salvailuciano/PPS/README.md

# PPS LIECOM

## Cómo poner la placa ESP32 en modo "Programacion"
1. Conectar cable USB
2. Apretar el botón "BOOT" de la placa
3. Soltar boton cuando aparezca programando en arduino
