salvailuciano/PPS/5_Informacion del Ale/Proyecto Reemplazo V7S-00-ÍNDICE.odt

PROYECTO REEMPLAZO V7S-00-ÍNDICE

R2021-09-27. (2 pág.)

Borrador comentarios preliminares para analizar en fábrica sobre voltímetro control.

01- CONTROL. (2 pág.)

Borrador idea genérica de análisis en fábrica de anexar posibles funciones de control.

P0794A_HD.pdf (1 pág.)

Borrador idea hardware mediciones y control.

02- GENERALIDADES. (2 pág.)

Funciones como voltímetro. Cantidad canales y multiplexación. Promediación. Resolución mediciones. Resolución display. Loop mediciones. Escalas en Eeprom.

03- PROMEDIACIÓN. (1 pág.)

Algoritmos para promediar cada canal.

04- ESCALAS. (1 pág.)

Conversión de salidas de los adc a valores a mostrar en display. Datos no volátiles (Eeprom).

05- FORMATOS PRESENTACIÓN DISPLAY. (2 pág.)

Presentación para mediciones lineales, cuadráticas y cuadráticas con máxima resolución.

06- EEPROM ESCALAS. (2 pág.)

Parámetros guardados en eeprom para calibración entradas analógicas. Display en modo vúmetro.

07- EEPROM REFERENCIA. (3 pág.)

Muestra organización eeprom equipos anteriores para tener como referncia.

08- PROTOCOLO COMUNICACIÓN. (6 pág.)

Muestra protocolo comunicación con PC en otros equipos. Tenerlo presente para tratar de hacer similar o compatible.

09- DIAGRAMA CONTROL GENERAL. (1 pág.)

Descripción resumida de posibles funciones de control a desarrollar.

P0794-A_DF-VOLT Y CTRL CON MICRO Rev1.pdf (1 pág.)

Diagrama funcionamiento Control General.

10- DETALLES CONTROL GENERAL. (6 pág)

Explicación Diagrama Control General.

continúa.....

Salida dac Ajuste de Potencia.

Salida pwm ventiladores.

Funciones Teclado y Leds.

Logbook eventos.

Proyecto Reemplazo V7S-00-ÍNDICE.odt 09/11/2021 de 1
