salvailuciano/PPS/5_Informacion del Ale/Proyecto Reemplazo V7S-01-CONTROL.odt

La placa de mediciones digitales deberá encargarse también del Control General del equipo. Esto es fijar modo de encendido, realizar las distintas protecciones, ajustar la potencia del equipo, etc.

Para el diseño funcional de los bloques de Control General (del Tx), se tomará referencia el funcionamiento de las placas P0167, P0490 y P0534, y para implementarlo con el (mismo) microcontrolador, este recibirá las siguientes informaciones, y generará las salidas que correspondan:

Lecturas entradas Lógicas

-Ingreso señal eléctrica LÓGICA ENC AUT en entrada LÓGICA.

-Ingreso señal eléctrica LÓGICA falla >>ROE en entrada LÓGICA.

-Ingreso señal eléctrica LÓGICA falla >>TEMP en entrada LÓGICA.

-Ingreso señal eléctrica LÓGICA P50 EXT en entrada LÓGICA (equipos FM1K / 2K).

-Ingreso señal eléctrica LÓGICA falla -VGG en entrada LÓGICA (P0167-B en TRM2640).

-Ingreso señal eléctrica LÓGICA apagado externo (posible uso futuro).

Lecturas entradas Analógicas

-Ingreso señal eléctrica ANALÓGICA NTC1 en entrada ADC.

-Ingreso señal eléctrica ANALÓGICA NTC2 en entrada ADC (estas entradas ADC no irían multiplexadas con las ADC de mediciones a mostrar en el display porque tienen interfaz entrada distinta).

-(analizar posible entrada para un tercer NTC3 en entrada ADC).

-Ingreso señal eléctrica ANALÓGICA Ref Temp NTC (definir si LM35 local o Med Temp Aire).

-Compartir ingreso señales eléctricas ANALÓGICAS de PD, PR y PEXC para el AGC y PMOD y VFTE para MUTE del AGC.

Lectura configuraciones en Eeprom seteadas desde PC por Lie

-Lectura de Eeprom VALOR (seteado desde PC) tipo de P0167/490: si <<VENT apaga FTE (P0490-A), ó saca Low en HVGG (pin 9 P0490-C), ó saca High en <<VENT (pin 9 P0490-D), ó <<VENT2 saca High en <<VSUM (pin 9 P0490-E); ó falla -VGG apaga (pin 1 P0167-B para TRM2640). Cada una de estas opciones además afecta la lógica si <<VENT apaga o no Tx.

-Lectura de Eeporm VALOR número ADC para referencia MED TEMP AIRE para <<VENT.

-Lectura de Eeprom VALORES ajuste comparadores VNTC para T_AIRE=0, para T_AIRE=40 y valor HISTÉRESIS (para simpleza se considerará como si la VNTC fuese lineal con la temperatura).

-Lectura de Eeprom si la actuación de >>T debe enclavar o no.

-Lectura de Eeprom qué entradas analógicas se usaría como med. de Temp. en caso de amplificadores sin termostáto (con P0673) para usar como >>TEMP e histéresis.

-Lectura de Eeprom VALOR PNOMinal del Tx.

-Lectura de Eeprom ubicaciones (entradas analógicas) mediciones PD, PR, PEXC y PMOD, y valores comparadores para AGC (PD_NOM, PE_NOM, PR_Foldback) y umbral PMOD, y rango (VMÍN, VMÁX), velocidad actuación AGC (pendiente V PIN respecto diferencia PD-PSET; también si deberán o no tener efecto c/u (PD, PR, PEXC y PMOD).

-Lectura de Eeprom VALORES Temp1 y Temp2 entre los cuales el PWM para turbinas (en caso de contemplarse en este diseño) dará un DC del 0% y del 100% respectivamente, y cuál entrada ADC se tomará como referencia (la del Aire, la del AMPL, etc).

-Lectura de Eeprom ubicaciones medición fuentes y valores de V a comparar para indicar Falla de Fuente (es una falla que no la venimos acusando pero suele ser bastante común en los equipos).

-Lectura de Eeprom retardo encendido automático al recibir señal del modulador, y retardo apagado al cesar.

Lecturas configuraciones en eeprom seteadas desde teclado por usuario Control en Tx

-Lectura de Eeprom estado LÓGICO (seteado desde teclado) Encendido Manual / Automático.

-Lectura de Eeprom estado LÓGICO (seteado desde teclado) Manual SI / NO.

-Lectura de Eeprom estados LÓGICOS (seteado desde teclado) cómo arranca al conectar 220 si se encontraba en MAN/SI o en AUT y con entrada de ENC AUT (APAG, ENC, ó como venía estando al cortarse 220).

-Lectura de Eeprom VALOR (seteado desde teclado) potencia deseada PSET (para AGC mediante microcontrolador).

Señales de Salida del uC para Control General del Tx

-Salida LÓGICA <<VENT/<<VENT2/LowHVGG/....Como ya se mencionó el pin 9 funciona de distintas maneras, y se indicó su lógica de acuerdo a la versión de la P0490 que corresponda (o la función homóloga en el pin 1 de la P0167). Quedará por definir si convendrá en el PCB hacer que sean pines distintos (y así podría evitarse ese seteo en la eeprom) pero consumiríamos más pines del microcontrolador.

-Salida LÓGICA Led Verde. Para indicar funcionamiento normal del Tx.

-Salida LÓGICA Led Rojo de APAG. Para indicar equipo apagado (por usuario).

-Salida LÓGICA Led Rojo. Para indicar fallas (ROE, TEMP, VENT, Fuente?, ....

-Salida LÓGICA Led Amarillo. Para indicar FoldBack ROE, o AGC controlado por EXC, o AGC al máx, ...(este led podría evitarse haciendo actuar simultaneamente el Verde y el Rojo de fallas ahorrando un pin del micro pero usando un led especial RO+VE).

-Salida LÓGICA energización relé HAB FTE.

-Salida LÓGICA HAB 12V.

-Salida LÓGICA HVGG.

-Salida LÓGICA energización NTC (por verificar si puede ser siempre la misma que habilita al relé HAB FTE).

-Salidas DAC para generar VAGC (hay uC con DACs de 5 bits; se utilizarían 2 DAC para 10 bits).

-Salida PWM VREF POT (opción en caso de no implementarse los DAC y AGC controlado).

-Salida PWM control ventiladores (opción a analizarse su implementación).

Otras conexiones del uC

-Entradas analógicas (cantidad dependerá de hardware de multiplexación).

-Display LCD (un LCD de 2 x 16 C utiliza unos 11 pines).

-Teclado (a definir, unos 5 pines).

-Comunicación con PC: dos pines Tx y Rx.

-Firmware: 3 pines.

Proyecto Reemplazo V7S-01-CONTROL.odt 30/09/2021 2 de 2
