salvailuciano/PPS/5_Informacion del Ale/Proyecto Reemplazo V7S-04-ESCALAS.odt

CONVERSIÓN SALIDA ADC AL VALOR A MOSTRAR EN DISPLAY

La calibración de la escala de cada canal a medir, se realizará por software según un conjunto de valores guardados en la eeprom.

Esto se hará mediante la PC conectada a la plaqueta (mas adelante se indicará si también será necesario poder hacer calibración desde el teclado).

El procedimiento sería como sigue:

Para cada canal en particular (16), una vez ingresado al menú de calibración, y habiendo leído desde la eeprom las características de LIN/CUAD, y de PROMEDIACIÓN del canal, se pondrá una tensión en la entrada correspondiente, para la que en la PC se mostrará en formato decimal un número correspondiaente a la salida promediada de ese adc (entre 0 y 1023, por ejemplo 789 y es para asegurar que la tensión de entrada esté en un valor razonable), y entonces en otro campo el usuario escribirá el valor que debiera mostrar el display una vez calibrado para esa entrada (digamos 1000), luego pulsando INTRO deberán quedar registrado en la eeprom para ese canal (2 bytes para CalADC y 2 bytes para CalDISPLAY), los valores CalADC (=789) y CalDISPLAY (=1000) respectivamente, finalizando así su calibración.

Luego para mostrar el valor adecuado en cada momento en el display, para ese canal, se deberá utilizar la fórmula que corresponda según sea lineal o cuadrática (atributo leído de la eeprom):

-para medición de escala cuadrática (como las mediciones de potencias) la fórmula a aplicar sería:

Px =[adc promediada / CalADC]^2 * CalDISPLAY

Px =[adc promediada / 789]^2 * 1000

si adc promediada fuese = 605, entonces Px sería = 588 W

-si la medición es de escala lineal (como mediciones de tensiones) la fórmula a aplicar sería:

Vx =[adc promediada / CalADC] * CalDISPLAY

Vx =[adc promediada / 789] * 1000

si adc promediada fuese = 801, entonces Vx sería = 1015 V

Al alimentar la plaqueta, el microcontrolador leerá de cada canal los valores en eeprom, y calculará para almacenar en ram CalDISPLAY / CalADC ^2 para las cuadráticas, y CalDISPLAY / CalADC para las lineales, con la resolución (cantidad de bits) suficiente.

USO DE LA EEPROM

La calibración ocuparía así, para cada canal (de 16) 4 bytes. Pero además al menos se dispondrían dos juegos de calibración (uno seteado antes de poner el equipo en marcha, y otro al momento de calibrar), sumando 8 bytes.

Además por canal consumirá 10 bytes para nombre y unidad de medición, un byte para modo LIN/CUAD y para PROMEDIACIÓN, y uno más para fondo escala vúmetro cuando corresponda. O sea unos 8 bytes más 12 bytes por canal.

Proyecto Reemplazo V7S-04-ESCALAS.odt 13/10/2021 de 1
