salvailuciano/PPS/5_Informacion del Ale/Proyecto Reemplazo V7S-05-RESOLUCIÓN DISPLAY.odt

FORMATOS PRESENTACIÓN DISPLAY

Al considerar el tipo de display a utilizar, se prevé que la presentación sea de las siguientes formas:

0,001 hasta 1,999; 0,01 hasta 19,99; 0,1 hasta 199,9; 1 hasta 1999.

El fondo de escala de 3 1/2 dígitos (apróx. 2000) debe permitir las cuatro posiciones posibles de ubicación del punto decimal indicados.

Y la resolución (ubicación del punto decimal) quedará determinado al momento de realizar la calibración para cada canal, y para mediciones lineales tendrá el punto en una única posición para cada canal sin importar el valor de salida de su adc, mientras que para mediciones cuadráticas habrá dos modos (fijados en eeprom desde la PC, para cada canal cuadrático en particular): uno con punto fijo como las lineales, y otro de máxima resolución. O sea resumiendo definiremos como Lineal, Cuadrática, y Cuadrática Máxima Resolución (este aplicable solo a las cuadráticas).

Aparte el hecho de no tener preset (mecánico o electrónico) antes de la entrada del adc, hará que la resolución del canal no sea aprovechada al máximo, porque para cierto fondo de escala en el display, la salida de ese adc puede estar cerca de 1023 (máximo aprovechamiento), o puede estar más cerca del 0; para el diseño supondremos que tenga capacidad para mostrar a fondo de escala cuando el adc esté en el orden de 128.

Veremos los cálculos y las posibles presentaciones en el display.

Mediciones Lineales con fondo de escala adc cercano a 1024:

ADC promediado Escala 2000 Escala 200,0 Escala 20,00 Escala 2,000

Eeprom CalDISPLAY p/ CalADC=1024 2000 200,0 20,00 2,000

ADC 1022 Cálculos 1996,094 199,6094 19,96094 1,996094

Mostrar en Display (Lineal) 1996 199,6 19,96 1,996

ADC 0001 Cálculos 1,953 0,1953 0,01953 0,001953

Mostrar en Display (Lineal) 2 0,2 0,02 0,002

Mediciones Lineales con fondo de escala adc cercano a 128:

ADC promediado Escala 2000 Escala 200,0 Escala 20,00 Escala 2,000

CalDISPLAY si CalADC fuese 128 2000 200,0 20,00 2,000

Eeprom CalDISPLAY p/ CalADC=1024 16000 1600 160 16

ADC 0127 Cálculos 1984,375 198,4375 19,84375 1,984375

Mostrar en Display (Lineal) 1984 198,4 19,84 1,984

ADC 0001 Cálculos 15,625 1,5625 0,15625 0,015625

Mostrar en Display (Lineal) 16 1,6 0,16 0,016

Mediciones Cuadráticas con fondo de escala adc cercano a 1024:

ADC promediado Escala 2000 Escala 200,0 Escala 20,00 Escala 2,000

Eeprom CalDISPLAY p/ CalADC=1024 2000 200,0 20,00 2,000

ADC 1022 Cálculos 1992,195 199,2195 19,92195 1,992195

Mostrar en Display (Cuadrático) 1992 199,2 19,92 1,992

Mostrar en Display (Cuad Máx Res) 1992 199,2 19,92 1,992

ADC 0023 Cálculos 1,009 0,1009 0,01009 0,001009

Mostrar en Display (Cuadrático) 1 0,1 0,01 0,001

Mostrar en Display (Cuad Máx Res) 1,009 0,101 0,010 0,001

ADC 0001 Cálculos 0,00191 0,000191 0,0000191 0,00000191

Mostrar en Display (Cuadrático) 0 0,0 0,00 0,000

Mostrar en Display (Cuad Máx Res) 0,002 0,000 0,000 0,000

Mediciones Cuadráticas con fondo de escala adc cercano a 128:

ADC promediado Escala 2000 Escala 200,0 Escala 20,00 Escala 2,000

CalDISPLAY si CalADC fuese 128 2000 200,0 20,00 2,000

Eeprom CalDISPLAY p/ CalADC=1024 128000 12800 1280 128

ADC 0127 Cálculos 1968,872 196,8872 19,68872 1,968872

Mostrar en Display (Cuadrático) 1969 196,9 19,69 1,969

Mostrar en Display (Cuad Máx Res) 1969 196,9 19,69 1,969

ADC 0003 Cálculos 1,0986 0,10986 0,010986 0,0010986

Mostrar en Display (Cuadrático) 1 0,1 0,01 0,001

Mostrar en Display (Cuad Máx Res) 1,099 0,110 0,011 0,001

ADC 0001 Cálculos 0,1221 0,01221 0,001221 0,0001221

Mostrar en Display (Cuadrático) 0 0,0 0,00 0,000

Mostrar en Display (Cuad Máx Res) 0,122 0,012 0,001 0,000

Observaciones:

- el decimal de menor peso mostrado en el display deberá estar redondeado según decimales no mostrados.
- Cuando el adc (promediado) da 1023 o mayor, se mostrará siempre >>>>. También cuando la indicación calculada fuese mayor a 1999, ó 199,9, ó 19,99, ó 1,999 (según escala a mostrar en el display) se mostrará >>>>.
- Las diferencias de presentación entre Cuadrático y Cuad Máx Res se presentan solo con los valores bajos de salidas de los adc; justamente la última opción, para un canal dado, muestra diferente posición del decimal para mostrar decimales ocultos por la Cuadrática.
- La fila "Eeprom CalDISPLAY p/ CalADC=1024" es solo una referencia para el caso en que en la eeprom se anotara en cada canal el valor a mostrar si el adc fuese 1024; pero ese método no se utilizaría por requerir más espacio de eeprom. Más adelante se indica alguna forma posible de aprovechar la Eeprom.

Proyecto Reemplazo V7S-05-RESOLUCIÓN DISPLAY.odt 14/10/2021 3 de 2
