salvailuciano/PPS/5_Informacion del Ale/P0794-A_HD.pdf

| Título: VOLT. Y CONTROL CON MICROCONTROLADOR | Plano Nº: P0794-A_HD
Equipo: NUEVOS | Dibujó: L.I.E. S.R.L.

# Modelo:

# Fecha:

# Archivo:

# Revisión:

Error : LOGO_LIE_NUEVO_REDUCIDO-CURVAS.BMP file not found.

01/10/2021 | P0794-A_HD.SCH

# VARIOS

### EEPROM FÁBRICA CONFIG TIPO TX

FUNC. EQUIV. P0167xx / P049xx

### EEPROM FÁBRICA CONFIG MEDICIONES (X16)

NOMBRE; ESCALA INICIAL; UNIDAD; LIN/CUAD; PROMED; MODO VALOR/VUM; CANT. MED (X1); PPAL AMPLIADA (X1)

### EEPROM FÁBRICA ESCALAS CALIBRADAS

### EEPROM FÁBRICA SETUP INICIAL

ENC MAN/AUTO; MAN SI/NO; MODO ENC. AL ARRANCAR P50 SI/NO; AJ. POTENCIA

### EEPROM FÁBRICA VALORES NOMINALES

AGC PEXC SI/NO; FOLDBACK SI/NO; MUTE PMOD SI/NO

NROS ADC (PD, PR, PEXC, PMOD, VFTE1, VFTE2, VCAG) VALORES PARA AGC (PD NOM; PR FOLDBACK; PEXC) COMP. C/ HISTÉRESIS (PMOD MUTE, VFTE1, VFTE2, VCAG)

(PARA INHIBIR FIJAR NROS O VALORES O COMP=0)

### EEPROM FÁBRICA SETUP DAC, PWM Y NTC

VMÍN DAC AGC; VMÁX DAC AGC; SLOPE DAC (dV/dP/dT) SLOPE DAC AL ARRANQUE (dV/dT)

### EEPROM FÁBRICA HABILITACIÓN PROTECCIONES

<<VENT SI/NO; >>T SI/NO; FOLDBACK ROE SI/NO

NROS ADC NTC 1 Y 2; NRO ADC TEMP REF
T INF COMP; V T INF; T SUP COMP; V T SUP; V HIST

NRO ADC TEMP VENT; T PWM=0; T PWM=100

TIME <<VENT APAGA; NRO ADC >>T; T>>T; HIST.T>>T

TOT <<VENT SI/NO; >>T ENCLAVA SI/NO

VALOR P50/PD NOM; T ENC AUT; T APAG AUT

### EEPROM USUARIO SETUP ACTUAL

ENC MAN/AUTO; MAN SI/NO; MODO ENC. AL ARRANCAR P50 SI/NO; AJ. POTENCIA

PC | TECLADO

# ENT AUX ?

# ENT AUX ?

# APAG EXT

P50X

# >>ROE

# >>TEMP

# ENC AUT

# NTC2

# NTC1

# MED 16

# MED 2

# MED 1

# VREF

# MPX

# MICROCONTROLADOR

# UART

# LÓGICA

# LÓGICA

# LÓGICA

# LÓGICA

# LÓGICA

# LÓGICA

# LÓGICA

# ADC

# ADC

# ADC

# ADC

# SAL AUX ?

# SAL AUX ?

# LEDS

# <<VENT

# HVGG

# HAB12V

# HABFTE

# SET VFTE

# SET RPM

SUM | SET VCAG

# LÓGICA

# LÓGICA

# LÓGICA

# LÓGICA

# LÓGICA

# LÓGICA

# LÓGICA

# PWM

# PWM

# DAC b5..b9

# DAC b0..b4

# DISPLAY

ICSP | 5VCC

# EEPROM

# ADC
