salvailuciano/PPS/5_Informacion del Ale/Proyecto Reemplazo V7S_R2021-09-27.odt

Delineamientos preliminares (para tratar con Laboratorio)

- El hardware requerirá estar cuidado de no sumar demasiado complejidad ni elementos de costos importantes, dado que el producto a desarrollar se destinará a equipamiento que no es la línea de “alta gama” de la empresa.
- Display tipo LCD de 16 o 20 x 2 caracteres (2 filas x 16 o 20 caracteres; en tlmd usamos 8 filas x 40 caracteres). Observar que tenga una visibilidad importante (limitación que suelen tener los LCD de poca superficie).
- Capacidad para medir entre 8 y 16 señales analógicas (configurable cada equipo).
- En el display se mostraría en la línea superior el nombre del parámetro a medir, y en el de abajo el valor y la unidad. Eventualmente en línea superior nombre y unidad, y en la inferior el valor en un extremo, y barra de vúmetro horizontal en el espacio restante.
- El valor será o bien linealmente proporcional, o en forma cuadrática con un coeficiente aplicados a las salida del adc correspondiente, para cada medición.
- Cada medición antes de ser presentada deberá poder ser promediada en unas tres formas distintas (en tlmd usamos 8 distintas): en una muestra, en N1 muestras o en N2 muestras, independientes para cada medición.
- Las escalas y calibración para cada medición deberá ser accesible y programable en cada equipo (ante una entrada de x voltios en un canal, se seteará que la indicación sea la deseada).
- Para mostrar las distintas mediciones se necesitará un teclado o pulsadores, de unos dos, o tres botones, o cuatro (UP/DOWN/LEFT/RIGHT), o cinco ( más ENTER), o que además incluya rueda que con su giro se avanza rápido en el menú de mediciones (observar costos).
- El teclado tendrá minimamente la función de scroll up y down para acceder a cada medición.
- Una vista más de una medición accedida por scroll up/down (y además aparecerá también después de un cierto tiempo sin pulsar teclado) será la medición principal (medición 1) en tamaño que los 3 1/2 dígitos (hasta 1999, incluyendo punto decimal opcional en tres posiciones hasta 3 decimales) ocupen todo el display (sin mostrar ni nombre ni unidad); para ello en ese momento el display (los 2 x 16 dígitos) funcionaría con dígitos diseñados convenientemente. Como opción de diseño, podría ser que esa vista aparezca un cierto tiempo después de que haya quedado seleccionada esa medición principal.
- Para el ajuste de parámetros de cada medición (cant. de mediciones 8/16/ o valor entre 8 y 16, nombre (7 caracteres), escala/calibración, lineal/cuadrática, unidad (3 caracteres), promediación, modo numérico o vúmetro, etc.) deberá desarrollarse minimamente una de las opciones siguientes: a_ una subrutina que permita programar totalmente con el teclado (así tenemos la P0492); b_ una salida de comunicación del voltímetro (venimos utilizando interfaz uart-ethernet TCP/IP tipo Tibbo, y sería como herramienta que tenemos y no cuenta su costo) más un software para hacer la programación desde una PC mediante ethernet/switch... (lo tenemos en la P0492 y en la P0568); c_ eventualmente ambas opciones anteriores (como en la P0492).

Opción A: incluir funciones mínimas control de encendido (mejor funcionalidad pero riesgo fallas)

- El teclado podría agregar las funciones de las dos llaves de la P0167 (MAN/AUTO y MAN SI/NO) para el control de encendido. Utilizaríamos dos pines del micro, uno para entrada ENC AUT desde modulador (o detección RF IN en el amplificador), y el otro para salida ENCENDER hacia la P0167 o equivalente.

Opción B: además incluir ajuste de potencia

- Una forma sería como venimos haciendo con la tlmd donde le enviamos pulsos (desde teclado) en entrada UP o en DOWN a un CI que es un preset electrónico de 64 posiciones (podrá estar el preset en la placa de AGC o en la misma placa del voltímetro), cuya salida va a la referencia de potencia en el AGC, y además en una entrada medimos la tensión de ese preset (la indicamos entre 0 y 63 con el nombre de SET_P).
- Otra forma mas sencilla de hacer lo mismo es que desde el teclado los pulsos para UP/DOWN de potencia vayan a un PWM interno que tienen los PIC, y la salida en un pin será una señal cuadrada a la que se le ajusta la relación tiempo ALTO/BAJO, y que luego filtrada con R-C queda una tensión media que se destina a referencia del AGC.
- Una forma distinta podría ser la siguiente: que la tensión de salida de un DAC o un generador de pendiente del micro o externo, filtrada, sea directamente la tensión a los diodos pin del AGC (y/o tensión de fuente para un FM). En estos casos, por ejm. un equipo de 1000W, si uno le fija ese valor con el teclado, el micro compara en cada momento la potencia actual con la fijada, y de acuerdo al error irá corrigiendo el DC del DAC haciendo la función de integrador de un AGC. Además se le setearía la velocidad con que se reajusta el DAC para así lograr que el AGC sea estable. Esta forma facilita la ventaja de que el equipo arranque siempre suavemente, e incluso si cierta señal (ejm. potencia modulador) no está presente, no arranque (evitando picos de potencia al conectar modulador por estar AGC al máximo). También permitiría funciones como Foldback en casos de ROE bajar la potencia, o también que la potencia del excitador no supere cierto valor (ante desperfecto en etapa de potencia). Las funciones mencionadas ya las venimos realizando en forma analógica en los equipos en racks.
  Con la función del DAC, habrá que verificar que su granularidad no genere ruido de AM en la señal de RF.

Opción C: agregado funciones de control y protecciones de la P0167/P0168

- Las distintas funciones de encendido y protecciones de la P0167 podrían implementarse aquí, ya sea en la misma placa del voltímetro, o en otra placa conectada a aquel mediante un cable de pocos hilos y un multiplexor de señales, dado que las funciones de control y protecciones involucran muchas señales a distintas partes del equipo.
- En una P0167 estamos teniendo cinco entradas (ENC AUT, >>ROE, >>TEMP, NTC1 y NTC2.
- Las salidas actuales son cuatro de uso corriente (HVGG, RHABFTE, 12HABFTE y HAB12V. Hay otras dos casi no utilizadas (NAGND para encender por bajo, y NC12V no utilizada). Salvo HVGG y HAB12V, las demás emergen de un relé, y que por confiabilidad debiera mantenerse.
- Cualquier condición de falla actuaría sobre algún led, y además el display tendrá que mencionar el tipo de anomalía.

Opción D: agregado control extra

- Con la medición de temperatura/s se puede actuar sobre un PWM para controlar ventiladores en equipo que justifiquen el costo.

Importante: cada señal o función que se agregue al diseño, requerirá más parámetros (y complejidad) a ser configurados.

Proyecto Reemplazo V7S_R2021-09-27.odt 17/09/2021 R27/09/2021 de 2
