salvailuciano/PPS/6_Papeles completos para mandar/Convenio específico_PS_Salvai Luciano.pdf

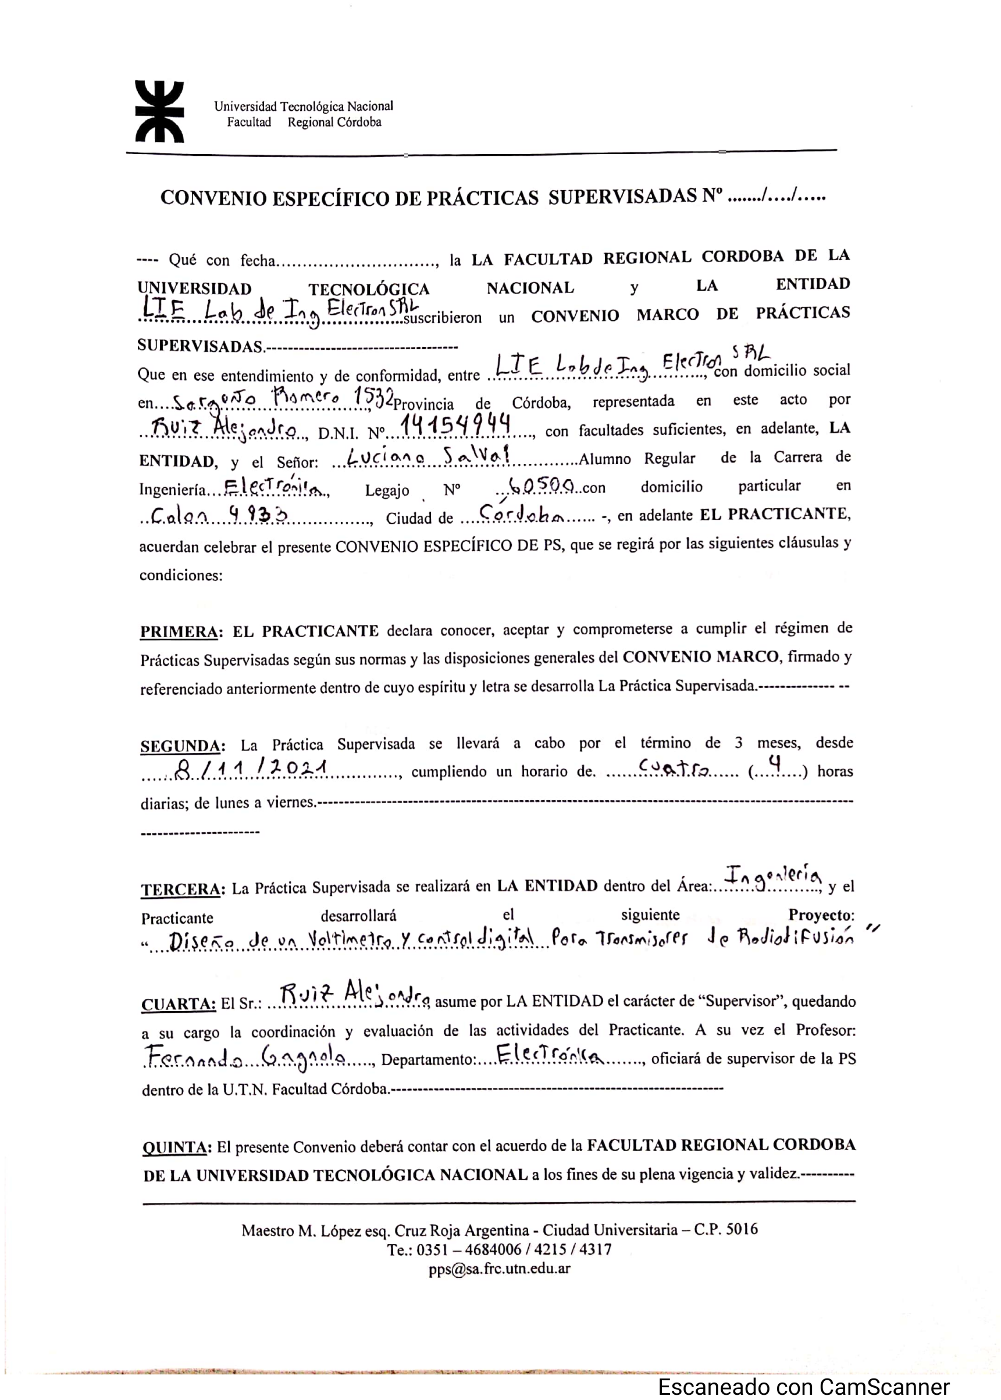
[picture p1: page 1]
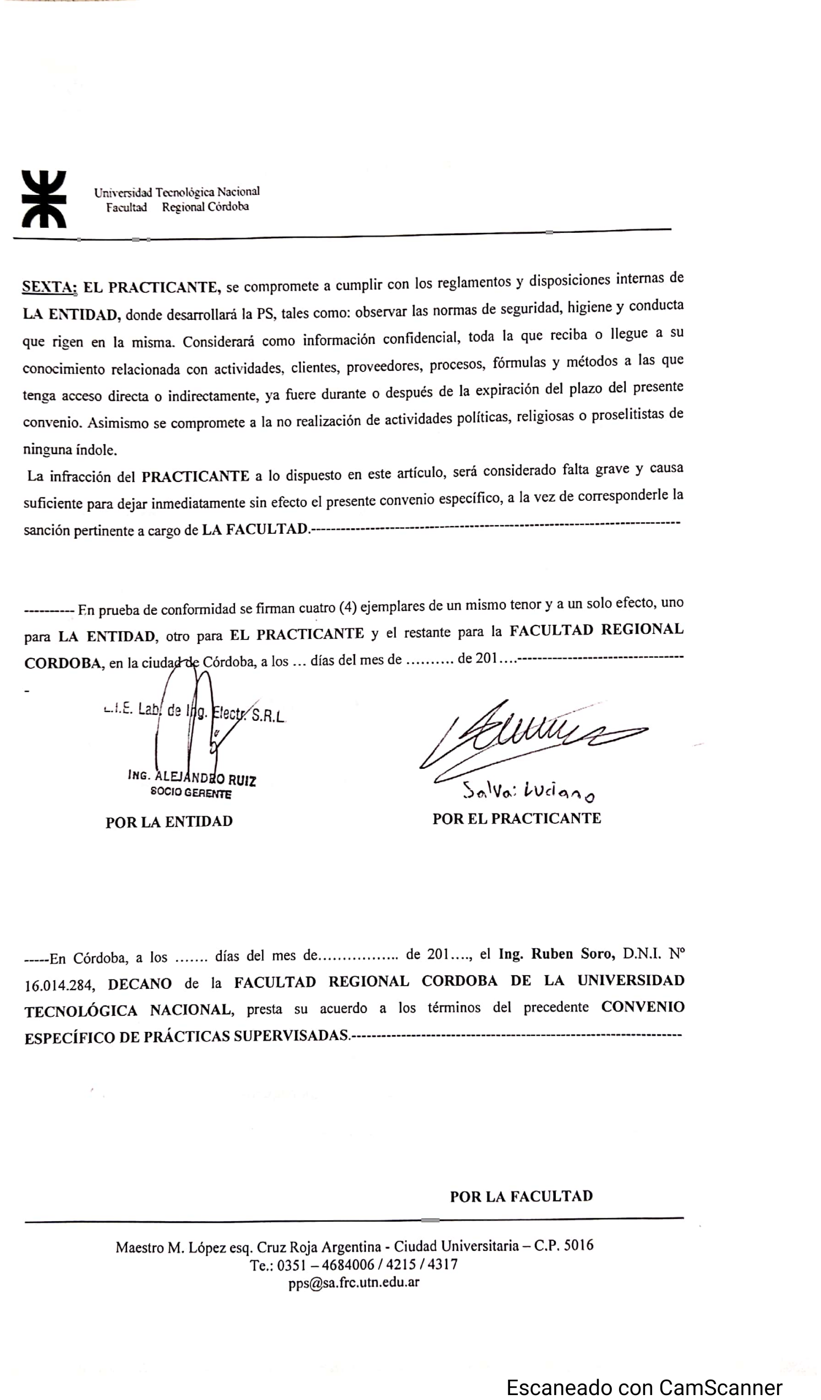
[picture p2: page 2]
