salvailuciano/PPS/6_Papeles completos para mandar/Convenio marco_PS_Salvai Luciano.pdf

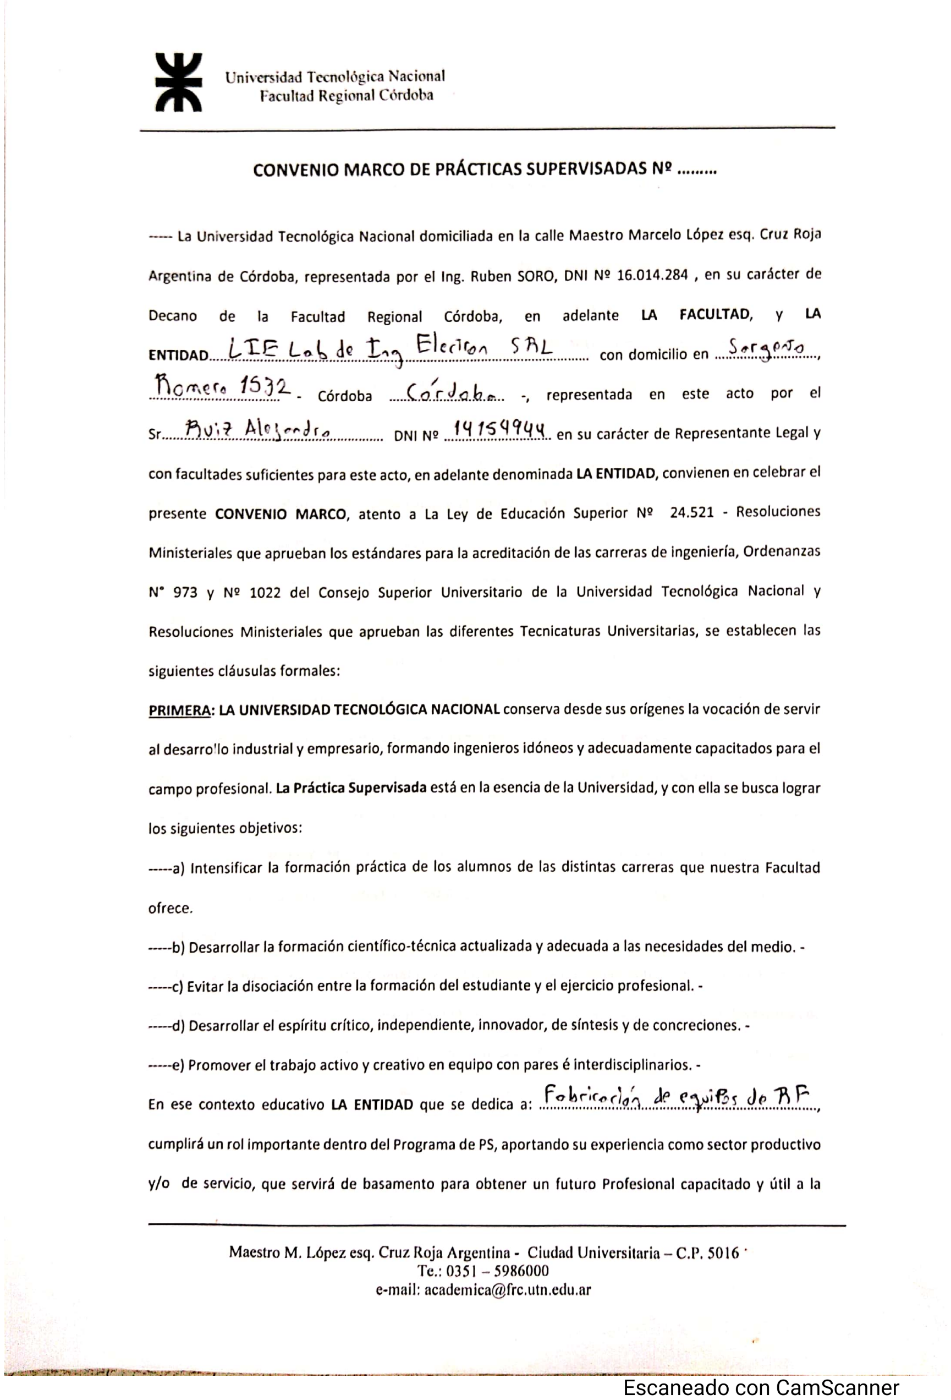
[picture p3: page 1]
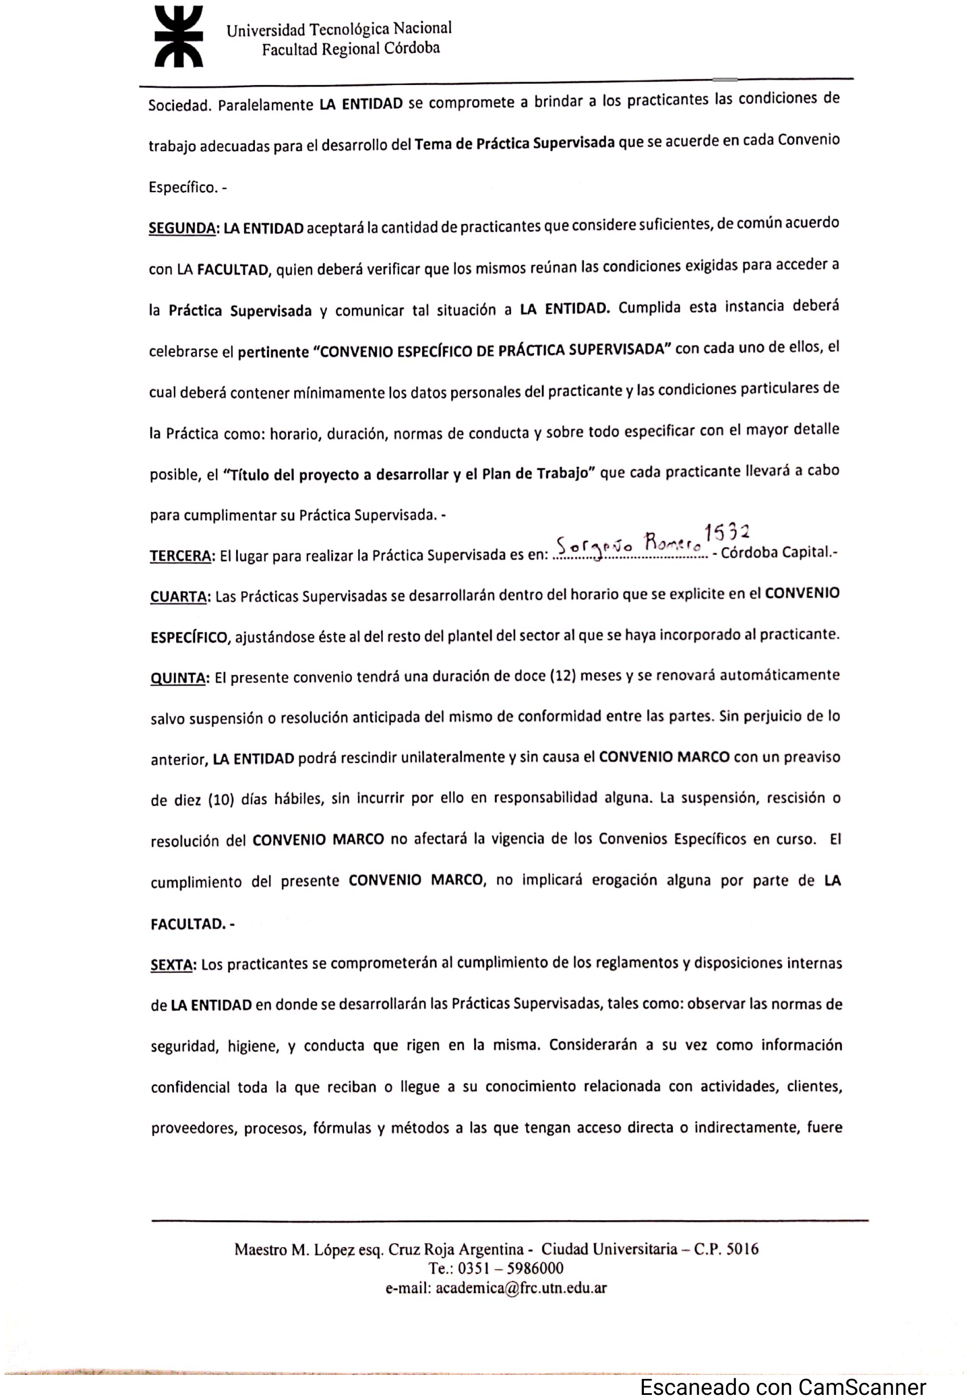
[picture p4: page 2]
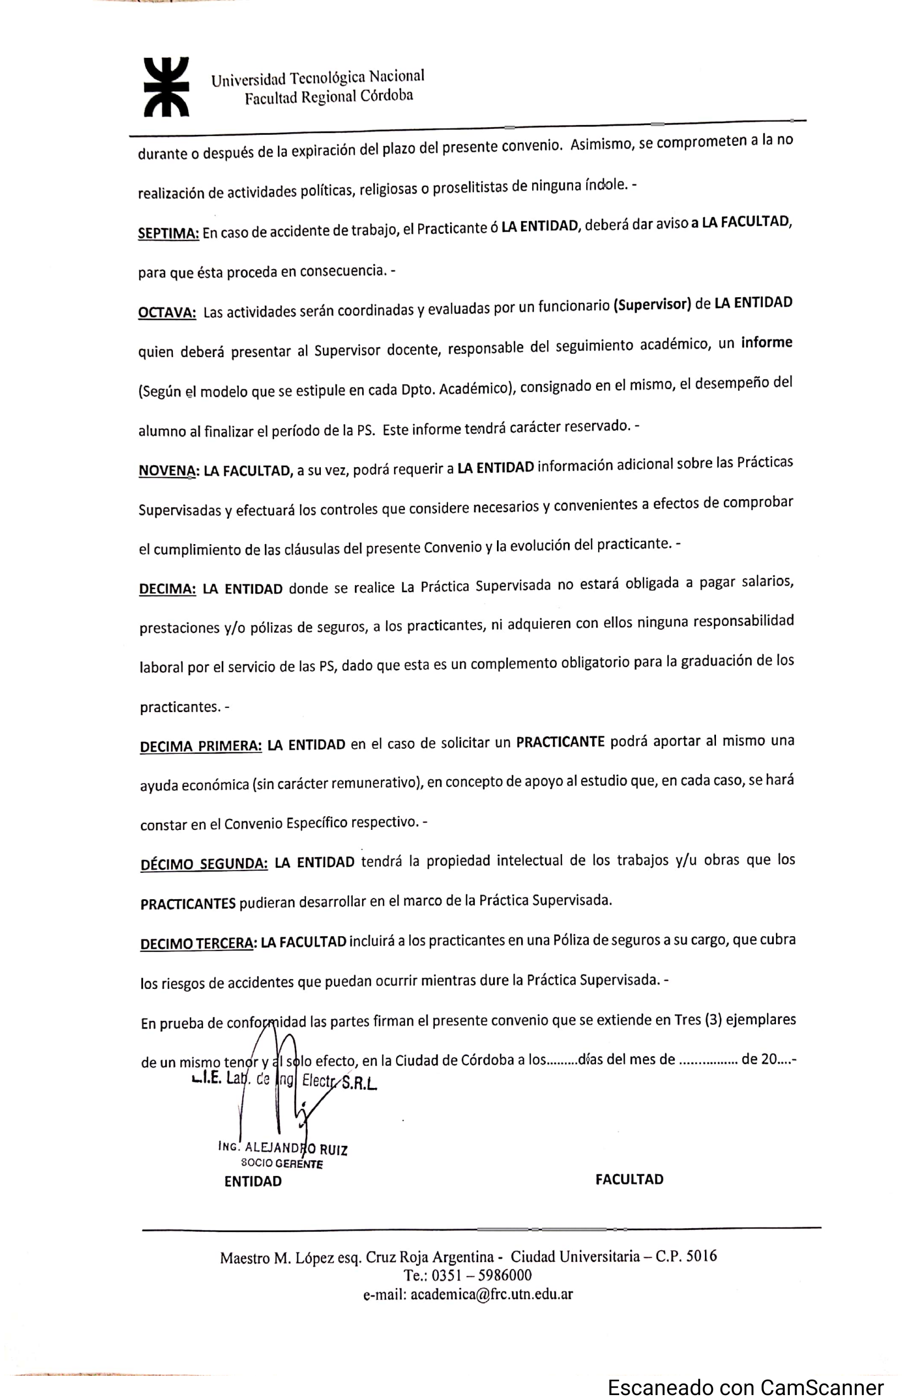
[picture p5: page 3]
