salvailuciano/PPS/6_Papeles completos para mandar/Solicitud_PS_Salvai Luciano.pdf

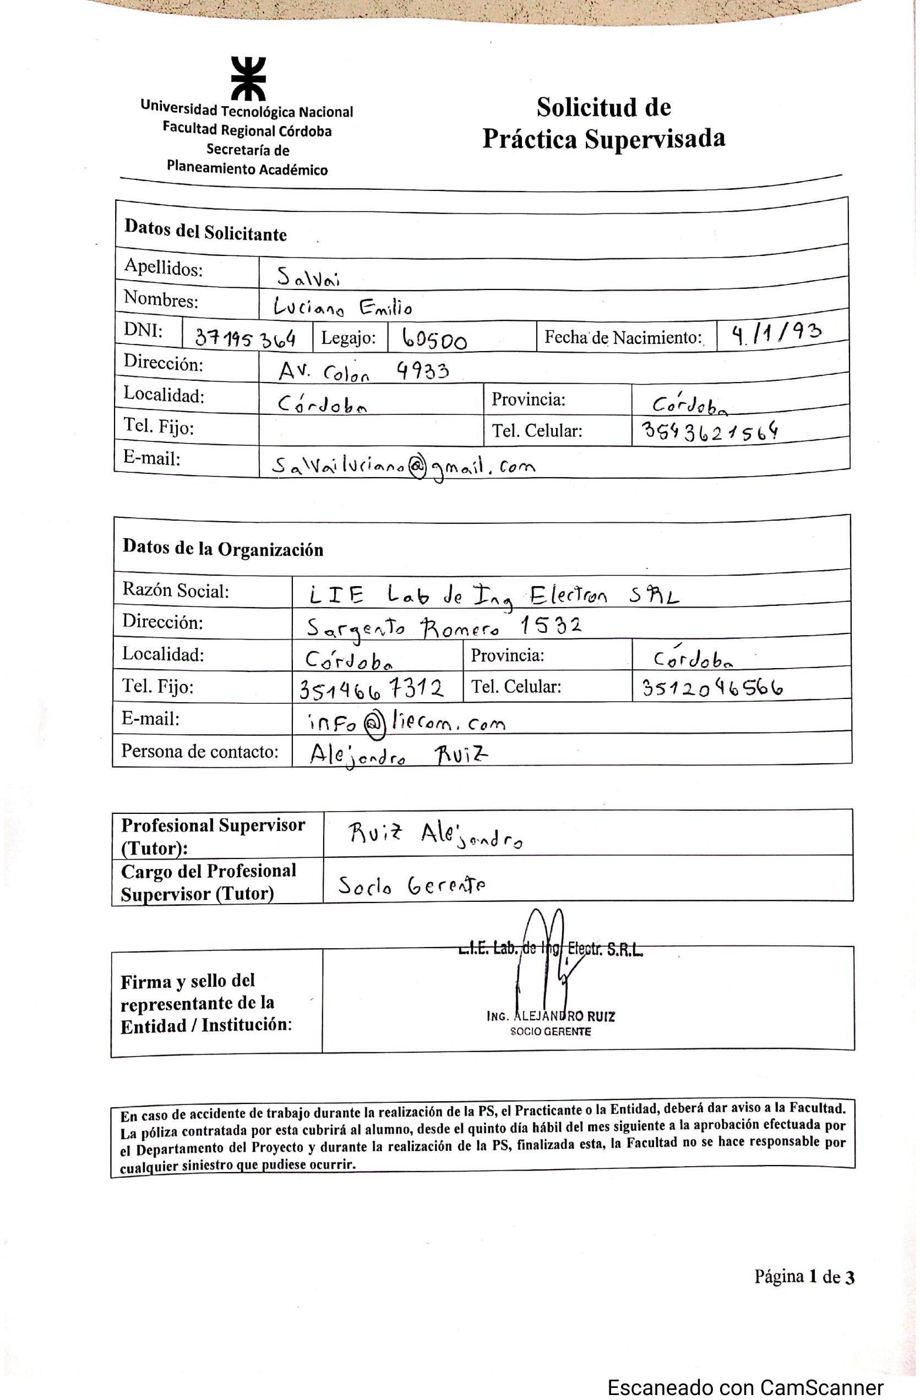
[picture p6: page 1]
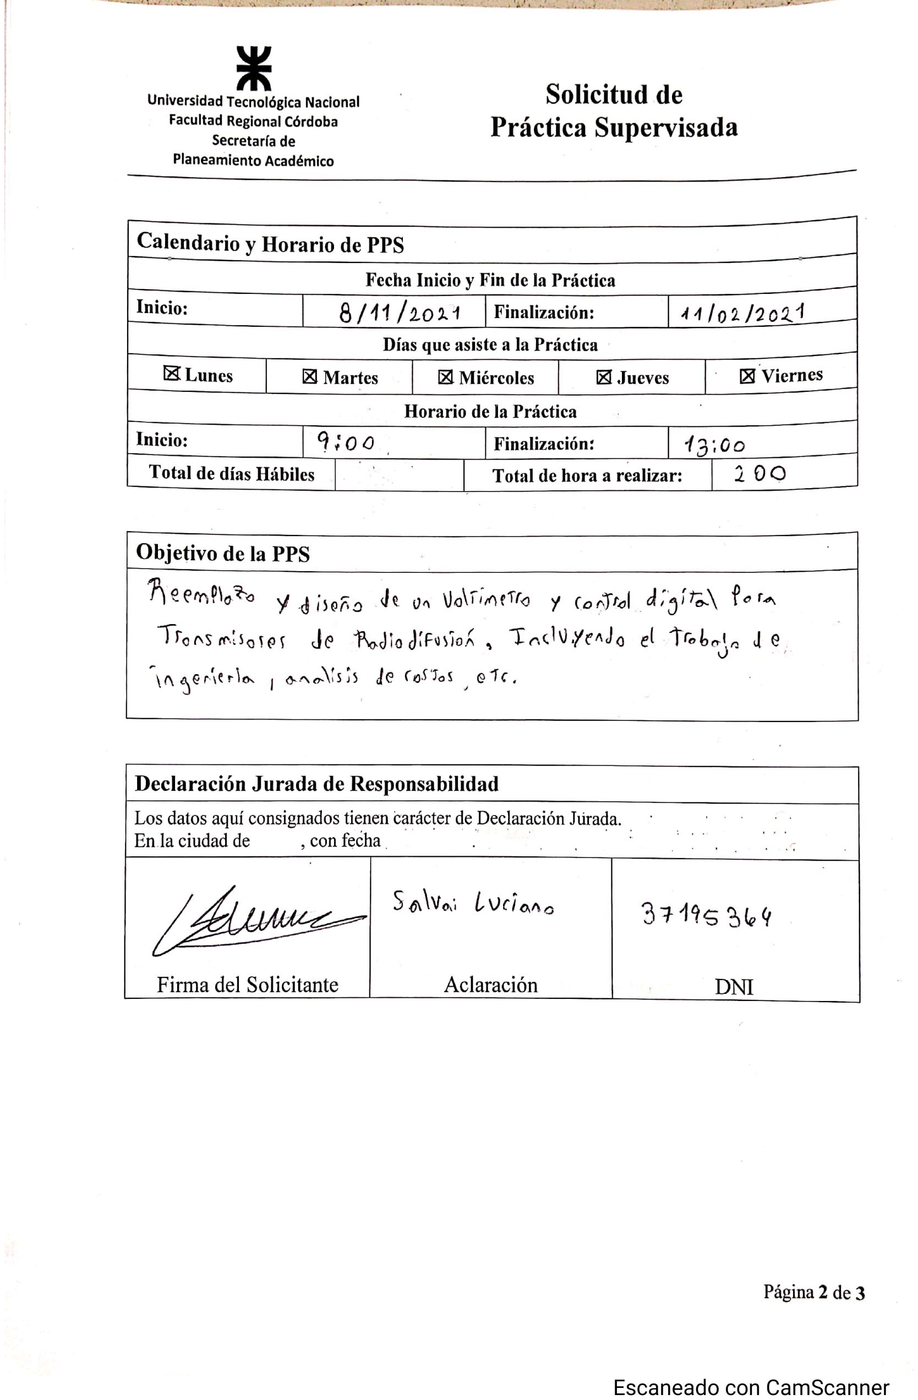
[picture p7: page 2]
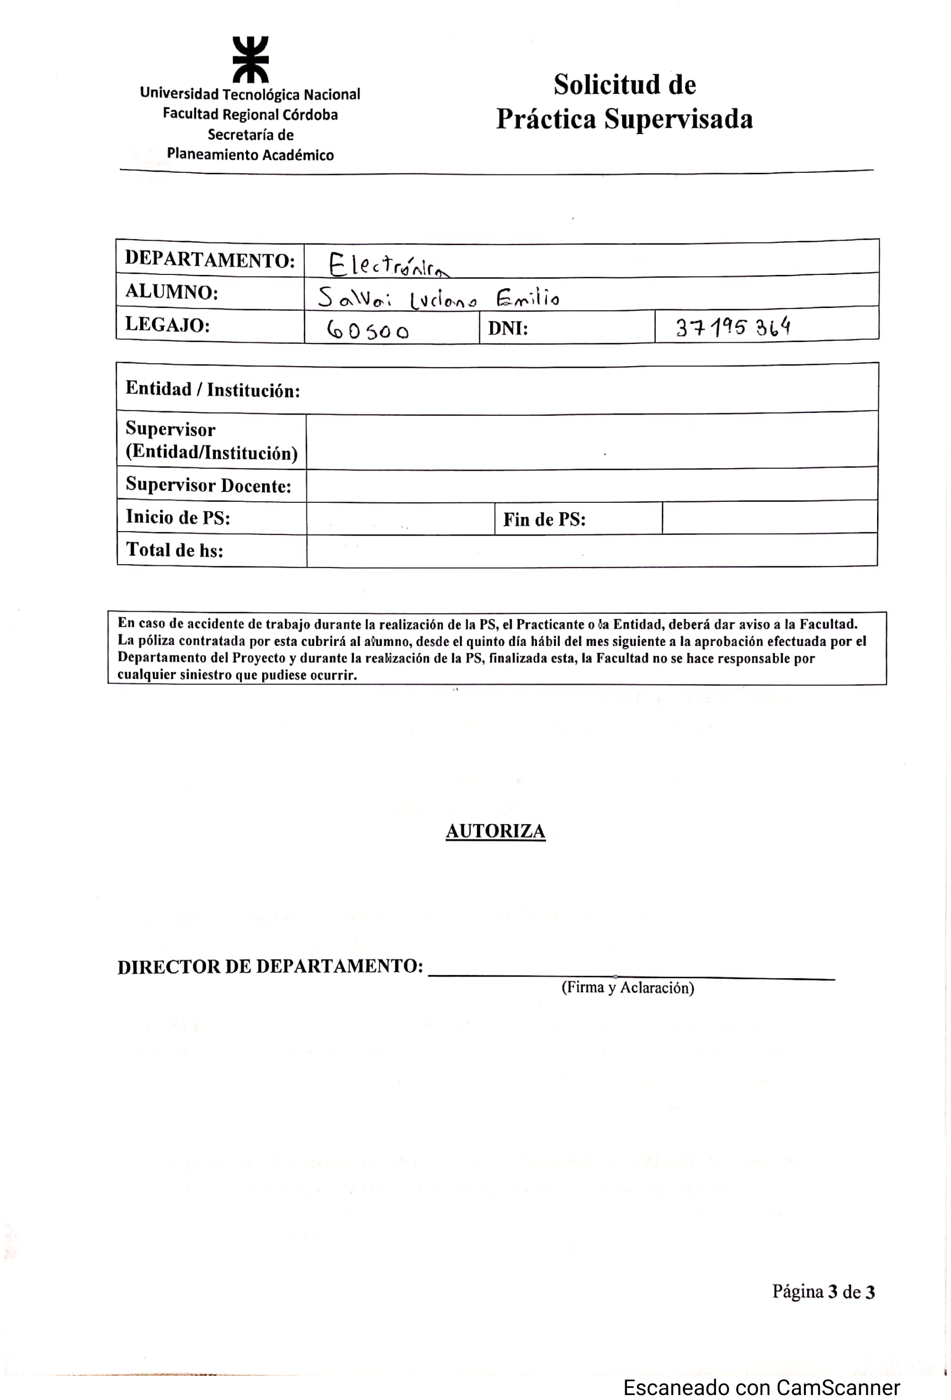
[picture p8: page 3]
