salvailuciano/PPS/2_Software/Ejemplos_codigos/VoltimetroDC0-30V/VoltimetroDC0-30V/Esquema divisor de tensión.pdf

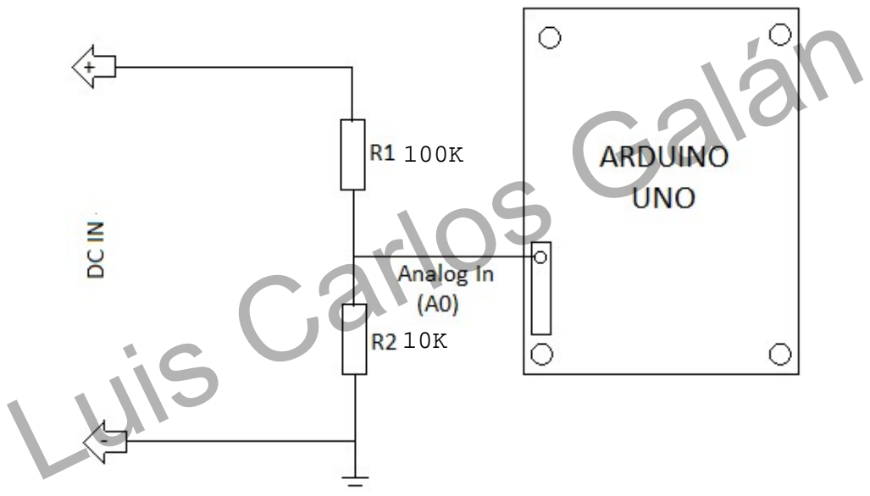
[picture p9: figure]
Luis Carlos Galán
