salvailuciano/PPS/2_Software/Ejemplos_codigos/VoltimetroDC0-30V/VoltimetroDC0-30V/Esquema Voltímetro digital 0 - 30 V Arduino.pdf

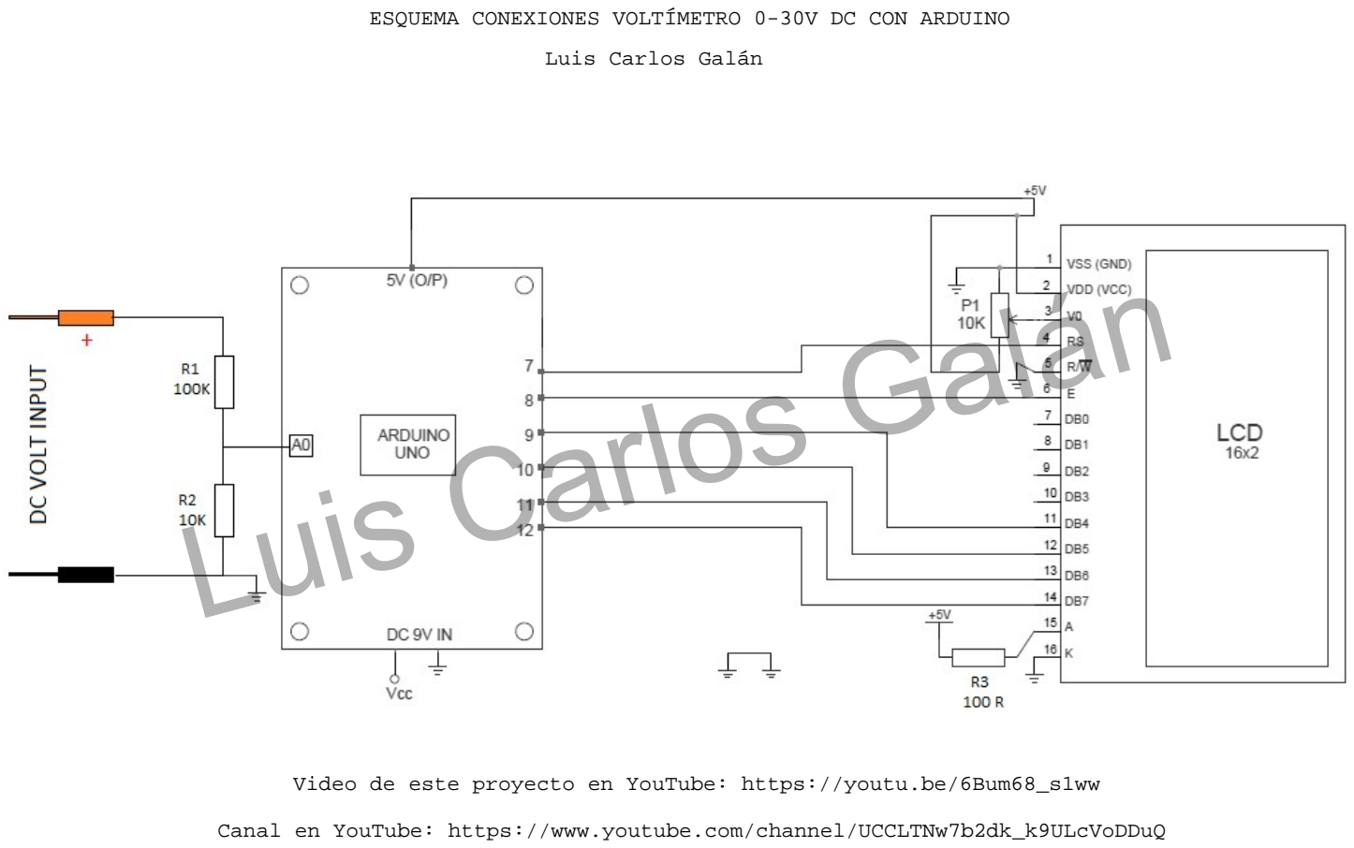
[picture p10: page 1]

Luis Carlos Galán
