salvailuciano/PPS/1_Hardware/Modelos3D/B3F-1000/B3F-1000.step

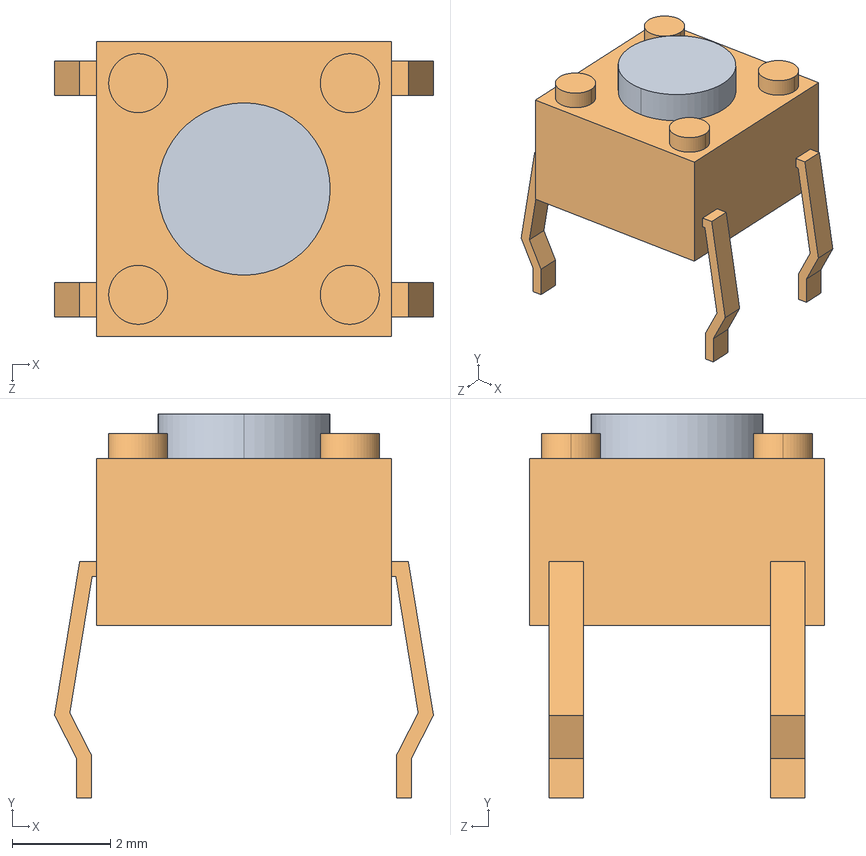
[picture p34: CAD file, 2022-10-07]
1_Hardware/Modelos3D/B3F-1000/B3F-1000.step
7.70 x 7.80 x 6.00 mm
B3F_1000_BUTTON
B3F_1000_BASE
