salvailuciano/PPS/1_Hardware/Modelos3D/L08R5000Q1/L08R5000Q1.step

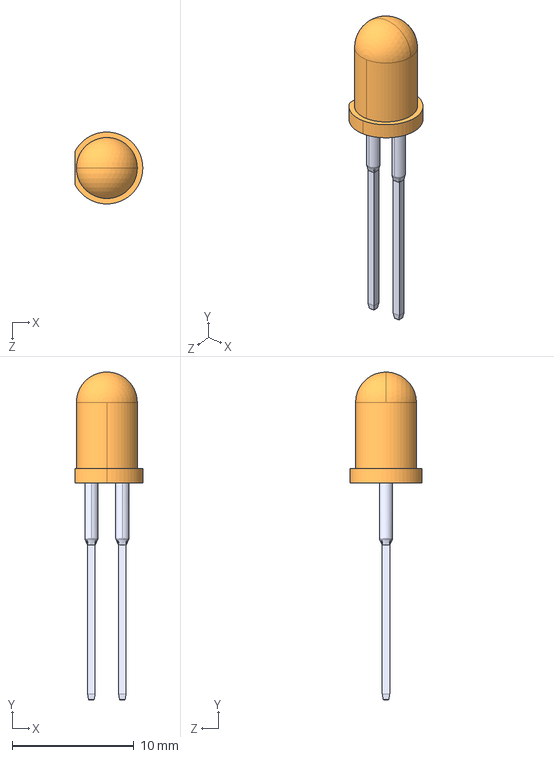
[picture p35: CAD file, 2022-10-07]
1_Hardware/Modelos3D/L08R5000Q1/L08R5000Q1.step
5.55 x 26.9 x 5.90 mm
