salvailuciano/PPS/5_Informacion del Ale/P0794-A_DF-VOLT Y CTRL CON MICRO Rev1.pdf

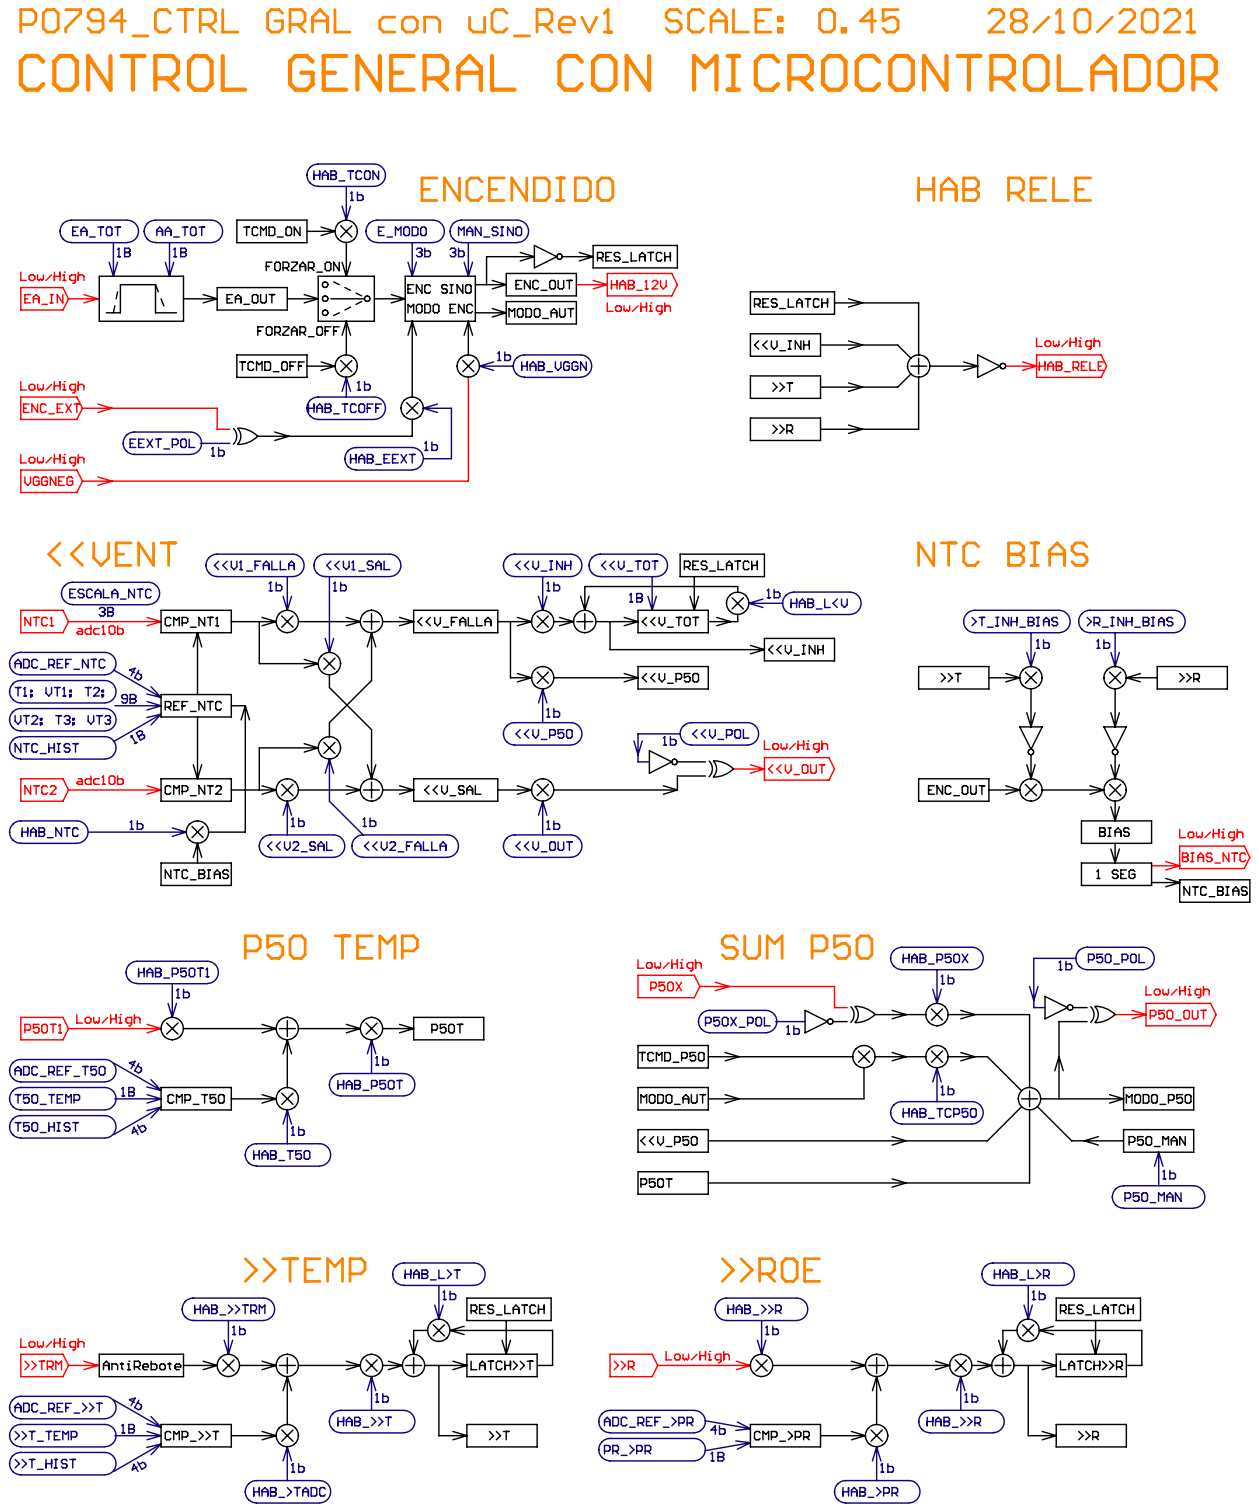
[picture p36: page 1]
