salvailuciano/PPS/(list of files, drawings)

Other design files:
1_Hardware/New Project.pdsprj
1_Hardware/Placa_esp32.pdsprj
4_Librerias/Importado_arduino/LiquidMenu-master/doc/Schematic/Arduino to HD44780.fzz
4_Librerias/Importado_arduino/LiquidMenu-master/examples/A_hello_menu/hello_menu.fzz
4_Librerias/Importado_arduino/LiquidMenu-master/examples/B_serial_menu/serial_menu.fzz
4_Librerias/Importado_arduino/LiquidMenu-master/examples/C_functions_menu/functions_menu.fzz
4_Librerias/Importado_arduino/LiquidMenu-master/examples/D_buttons_menu/buttons_menu.fzz
4_Librerias/Importado_arduino/LiquidMenu-master/examples/E_progmem_menu/progmem_menu.fzz
4_Librerias/Importado_arduino/LiquidMenu-master/examples/F_focus_menu/focus_menu.fzz
4_Librerias/Importado_arduino/LiquidMenu-master/examples/G_glyph_menu/glyph_menu.fzz
4_Librerias/Importado_arduino/LiquidMenu-master/examples/H_system_menu/system_menu.fzz
4_Librerias/Importado_arduino/LiquidMenu-master/examples/I_I2C_menu/I2C_menu.fzz
4_Librerias/Importado_arduino/LiquidMenu-master/examples/J_scrolling_menu/scrolling_menu.fzz
4_Librerias/Importado_arduino/LiquidMenu-master/examples/K_getters_menu/getters_menu.fzz
