salvailuciano/PPS/mainluchete/interrupciones.cpp

//Funciones que realiza al hacer una interrupcion respectivamente
void temperatura(){
  //codigo que realiza cuando se interrumpe//salida alarmas
}
void roe(){
  //codigo que realiza cuando se interrumpe//salida alarmas
}
