salvailuciano/PPS/mainluchete/calculosADC.cpp

//Las variables que usa esto son todas globales, menos el arreglo lectura[3], VER ESTE TEMA!!
/*
float calculosBitsADC(float lectura[3]){
  aux = (lectura[0] * 5.0) / 1024.0; // Cálculo para obtener el aux //Valor * voltaje/BitsADC
  corriente = aux /Iparametro; // Cálculo para obtener Vin del divisor de tensión
  corriente = (lectura[0]*5) / 1024;
  
  aux = (lectura[1] * 5.0) / 1024.0;
  aux = (aux*aux)/100;
  potenciad = aux *Pdparametro;
  potenciad = (lectura[1]*5) / 1024;
  
  aux = (lectura[2] * 5.0) / 1024.0;
  vex = aux /Iparametro;
  vex = (lectura[2]*5) / 1024;
  
  aux = (lectura[3] * 5.0) / 1024.0;
  agc = aux /Agcparametro;
  agc = (lectura[3]*5) / 1024;
}*/
