salvailuciano/PPS/2_Software/Ejemplos_codigos/Pulsioximetro_promedio_mediana_moda/Pulsioximetro_promedio_mediana_moda.ino

#include <Wire.h>
#include "MAX30105.h"
#include "spo2_algorithm.h"

MAX30105 particleSensor;
 
#define MAX_BRIGHTNESS 255
#define HR_PROM_INTERVAL 100
#define HR_MED_INTERVAL 99
 
#if defined(__AVR_ATmega328P__) || defined(__AVR_ATmega168__)
//Arduino Uno doesn't have enough SRAM to store 100 samples of IR led data and red led data in 32-bit format
//To solve this problem, 16-bit MSB of the sampled data will be truncated. Samples become 16-bit data.
uint16_t irBuffer[100]; //infrared LED sensor data
uint16_t redBuffer[100];  //red LED sensor data
#else
uint32_t irBuffer[100]; //infrared LED sensor data
uint32_t redBuffer[100];  //red LED sensor data
#endif
 
int32_t bufferLength; //data length
int32_t spo2; //SPO2 value
int8_t validSPO2; //indicator to show if the SPO2 calculation is valid
int32_t heartRate; //heart rate value
int8_t validHeartRate; //indicator to show if the heart rate calculation is valid
 
byte pulseLED = 11; //Must be on PWM pin
byte readLED = 13; //Blinks with each data read

//int values100[] = {50,6,7,8,9,10,44,11,12,13,14,3,15,45,16,48,17,18,42,2,19,20,43,12,22,49,23,24,1,4,26,27,28,5,29,46,30,31,32,33,34,47,35,36,37,38,39,40,41,25};

//////////////////////////////////////////////////////////////////SETUP////////////////////////////////////////////////////////////////
void setup()
{
  Serial.begin(115200); // initialize serial communication at 115200 bits per second:
 
  pinMode(pulseLED, OUTPUT);
  pinMode(readLED, OUTPUT);
 
  // Initialize sensor
  if (!particleSensor.begin(Wire, I2C_SPEED_FAST)) //Use default I2C port, 400kHz speed
  {
    Serial.println(F("MAX30105 was not found. Please check wiring/power."));
    while (1);
  }
 
  Serial.println(F("Attach sensor to finger with rubber band. Press any key to start conversion"));
  while (Serial.available() == 0) ; //wait until user presses a key
  Serial.read();
 
  byte ledBrightness = 250; //Options: 0=Off to 255=50mA
  byte sampleAverage = 1; //Options: 1, 2, 4, 8, 16, 32
  byte ledMode = 2; //Options: 1 = Red only, 2 = Red + IR, 3 = Red + IR + Green
  byte sampleRate = 100; //Options: 50, 100, 200, 400, 800, 1000, 1600, 3200
  int pulseWidth = 69; //Options: 69, 118, 215, 411
  int adcRange = 16384; //Options: 2048, 4096, 8192, 16384
 
  particleSensor.setup(ledBrightness, sampleAverage, ledMode, sampleRate, pulseWidth, adcRange); //Configure sensor with these settings
}
//////////////////////////////////////////////////////////////////INICIO////////////////////////////////////////////////////////////////
void loop()
{
  int hrPromedio = 0;
  int hrAcumulado = 0;
  int hrContador = 0;
  int values100[HR_MED_INTERVAL];
  int values100Length = sizeof(values100) / sizeof(int);
  int cont = 0;
  int med = 0;
  int moda = 0;
  
  bufferLength = 100; //buffer length of 100 stores 4 seconds of samples running at 25sps
 
  //read the first 100 samples, and determine the signal range
  for (byte i = 0 ; i < bufferLength ; i++)
  {
    while (particleSensor.available() == false) //do we have new data?
      particleSensor.check(); //Check the sensor for new data
 
    redBuffer[i] = particleSensor.getRed();
    irBuffer[i] = particleSensor.getIR();
    particleSensor.nextSample(); //We're finished with this sample so move to next sample
 
    Serial.print(F("red="));
    Serial.print(redBuffer[i], DEC);
    Serial.print(F(", ir="));
    Serial.println(irBuffer[i], DEC);
  }
 
  //calculate heart rate and SpO2 after first 100 samples (first 4 seconds of samples)
  maxim_heart_rate_and_oxygen_saturation(irBuffer, bufferLength, redBuffer, &spo2, &validSPO2, &heartRate, &validHeartRate);
 
  //Continuously taking samples from MAX30102.  Heart rate and SpO2 are calculated every 1 second
////////////////////////////////////////////////////////////////////LOOP REAL///////////////////////////////////////////////////////////
  while (1) 
  {
      //dumping the first 25 sets of samples in the memory and shift the last 75 sets of samples to the top
      for (byte i = 25; i < 100; i++)
      {
        redBuffer[i - 25] = redBuffer[i];
        irBuffer[i - 25] = irBuffer[i];
      }
 
      //take 25 sets of samples before calculating the heart rate.
      for (byte i = 75; i < 100; i++)
      {
        while (particleSensor.available() == false) //do we have new data?
          particleSensor.check(); //Check the sensor for new data
 
        digitalWrite(readLED, !digitalRead(readLED)); //Blink onboard LED with every data read
 
        redBuffer[i] = particleSensor.getRed();
        irBuffer[i] = particleSensor.getIR();
        particleSensor.nextSample(); //We're finished with this sample so move to next sample
 
        //send samples and calculation result to terminal program through UART
        Serial.print(F("red="));
        Serial.print(redBuffer[i], DEC);
      
      Serial.print(F(", ir="));
        Serial.print(irBuffer[i], DEC);
 
        Serial.print(F(", HR="));
      Serial.print(heartRate, DEC);
 
      Serial.print(F(", HRvalid="));
        Serial.print(validHeartRate, DEC);
 
        Serial.print(F(", SPO2="));
      Serial.print(spo2, DEC);
 
        Serial.print(F(", SPO2Valid="));
        Serial.print(validSPO2, DEC);

        Serial.print(F(", HRP=="));
        Serial.print(hrPromedio, DEC);

        Serial.print(F(", Mediana=="));
        Serial.print(med, DEC);
        
        Serial.print(F(", Moda=="));
        Serial.println(moda, DEC);
      }
//////////////////////////////////////////////////////////PROMEDIO//////////////////////////////////////////////////////////
      if(validHeartRate == 1 && heartRate <= 150)
      {
        hrAcumulado += heartRate;
        hrContador++;
        if(hrContador == HR_PROM_INTERVAL)
        {
          hrPromedio = hrAcumulado / hrContador;
          hrAcumulado = 0;
          hrContador = 0;
        }
      }
//////////////////////////////////////////////////////////MEDIANA//////////////////////////////////////////////////////////
if (validHeartRate == 1 && heartRate <= 210)
   { 
    Serial.println(cont);
    values100[cont] = heartRate;
    cont ++;
   }
   if(cont == HR_MED_INTERVAL)
   {
    int q, w, flag = 1;
    int temp;
    for (q = 1; (q < values100Length) && flag; q++)
    {
        flag = 0;
        for (w = 0; w < (values100Length - 1); w++)
        {
          if (values100[w + 1] < values100[w])
          {
              temp = values100[w];
              values100[w] = values100[w + 1];
              values100[w + 1] = temp;
              flag = 1;
          }
        }
    }
    med = values100[50];
    //Serial.println(med, DEC);
    //cont = 0;
    //delay(2000);
   }
//////////////////////////////////////////////////////////MODA//////////////////////////////////////////////////////////
if(cont == HR_MED_INTERVAL)
{
  int cont2;
  int valor;
  int cont3;
  int posicion;
  int cont4;
  int mayorvalor;
  int posicionmayor;
  int auxiliar[HR_MED_INTERVAL];
  
  for(cont2 = 0; cont2 < HR_MED_INTERVAL; cont2++) 
  {
        valor = values100[cont2];
        posicion = cont2;
        for(cont3 = cont2; cont3 < HR_MED_INTERVAL; cont3++) 
        {
            if(values100[cont3] == valor) auxiliar[posicion]++;
        }
    }
  mayorvalor = auxiliar[0];
  posicionmayor = 0;
  for(cont4 = 0; cont4 < HR_MED_INTERVAL; cont4++) 
  {
        if(auxiliar[cont4] > mayorvalor) 
        {
            posicionmayor = cont4;
            mayorvalor = auxiliar[cont4];
        }
    }
  moda = values100[posicionmayor];
  cont = 0;
}

////////////////////////////////////////////////////////////////////////////////////////////////////////////////////////
      //After gathering 25 new samples recalculate HR and SP02
      maxim_heart_rate_and_oxygen_saturation(irBuffer, bufferLength, redBuffer, &spo2, &validSPO2, &heartRate, &validHeartRate);
      
  }
}
