salvailuciano/PPS/2_Software/Ejemplos_codigos/Ejemplo_comunicacion_labview_Serial/arreglo_serial_3/arreglo_serial_3.ino

#define DEBUG(a) Serial.println(a);
String data = "";
void setup()
{
   Serial.begin(9600);
}
void loop()
{
   while (Serial.available())
   {
      char character = Serial.read();
      if (character != '\n')
      {
         data.concat(character);
      }
      else
      {
         Serial.println(data);
         data = "";
      }
   }
}
