salvailuciano/PPS/(commit log)

2022-04-28 Create voltimetro
2022-06-03 arreglado del main, se borro el main.cpp y se hizo backup del main.ino (viejo)
2022-06-03 agregado del backup de la forma correcta
2022-06-07 Se linkio y se puso en funcionamiento el programa
2022-06-07 Se agrego mux.h y mux.cpp y se linkio todo anda ok el programa
2022-06-07 Ordenado de las sheet de promediador y mux, cada cosa en su lugar. Ordenado basico y de estructura de todas las sheet y agregado de muchos comentarios para ayudar a recorrer el programa. Agregado de 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
    [calculosADC.cpp, menu.cpp, menu.h, mux.cpp, promediador.cpp]
2022-06-07 Mas arreglo de estructura de programacion(llaves, espacios y enters, etc), agregado de variable cantidadMediciones para reemplazar en varios lados, ya resuelto, y resuelto el problerma del warning en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
    [calculosADC.cpp, menu.cpp, mux.cpp, promediador.cpp]
2022-06-08 Se cambio el programa, por un lado se cambio el desplazamiento de encoder a botones. Se utilizan solo tres botones por ahora con posibilidad de 5 botones. Se omite temporalmente la promediacion para 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
    [Button.h, definesConfiguraciones.h, menu.cpp, menu.h, mux.cpp, promediador.cpp]
2022-06-08 Agregado del formato interrupciones con sus respectivos comentarios para ayudar. Las funciones de las interrupciones faltaria completar, y ver si es necesario desactivar las interrupciones en algun m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
    [interrupciones.cpp, interrupciones.h, menu.cpp]
2022-06-14 Agregado de lo que hicimos en mi casa, y agregado de la carpeta de visual studio code para empezar a programar desde ahi
2022-06-20 algo que me falto de vscode
2022-06-20 mainluchete, nose q onda, pero para no borrarlo
2022-07-04 Cambio grande en el main, quedo funcionando probado en pantalla serial de arduino, se borro practicamente lo de readyprom, y se crearon funciones adentro del main que despues hay que ver q hacer. Aho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
    [promediador.cpp]
2022-07-05 Se comento todo para mejor lecutra, se arreglo el tema de q cambie el canal del mux antes de promediar, asi le da tiempo a estabilizarse el ADC. Se acomodo la funcion promediador en su sheet y se dej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
    [calculosADC.cpp, definesConfiguraciones.h, menu.cpp, mux.cpp, promediador.cpp]
2022-07-05 Cambio de la seleccion de pines para que funcione con la ESP32, quedo funcionando perfectamente
2022-08-04 Bueno, lo deje andando con el 4052, tomando mediciones desde 2 pines(36 y 39) la funcion no retorna nada ahora, por que los valores promediados en cada llamada se guardan en unas variables globales.
2022-08-04 Ahora si se agrego, lo de quitar interrupciones
2022-08-09 Lo de hoy
2022-08-11 Se añade lectura de temperatura al pin 21
2022-08-11 Se añade la libreria sensor temperatura para testing
2022-08-16 Se reacomodan las carpetas, se agregan ejemplos para utilizar la eeprom interna de la esp32, se agregan ejemplos para una posible comunicacion serial con el labview u otro sistema para cambiar los pa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
2022-08-21 Se agrega configuracion de adc con los bits a configurar y una funcion para determinar el vref. Se observa que la esp32 no tiene una funcion de vref externa por lo que no sera posible en uso del tl43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
2022-08-22 Se configura la eeprom interna indexada a la calibracion para guardar los datos. Quedaria pendiente la comunicacion via pc para el cambio de los nombres de las mediciones y los valores de las mismas.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
2022-09-22 Se agrega funcion de numeros grandes para el programa
2022-10-07 Se repara error en display con respeto a las unidades que se mostraban. Se reparo la lentitud al calibrar las variables desde el teclado. Se arregla error con la eeprom que no siempre hacia correcta 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
    [B3F-1000.step, L08R5000Q1.step, New Project.pdsprj, Placa_esp32.pdsprj]
2022-10-11 Se termina de programar el prototipo de programa funcional con la posibilidad de hacer los ajustes y calibraciones tanto por medio de software serial como por teclado
2022-10-15 Se termina de programar completo. Se reparan bugs en la pantallque mostraba mal los valores. Se añaden opciones para configuracion serial y monitoreo. Se permite borrar la eeprom y reinicializarla. S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
    [adc.cpp, definesConfiguraciones.h, eeprom.cpp, eeprom.h, main.h, menu.cpp, menu.h]
2022-10-18 Se acomoda codigo y se borra todo lo que no se necesita. Se añade una interrupcion para mostrar los datos en pantalla cada medio segundo sacando todos los delay del programa. Ademas se agrega la posi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
2022-10-18 Se repara la rutina de interrupcion que hacia que el programa funcione con lentitud en pantalla
2022-10-19 Se acomoda toda la informacion y el programa
    [B3F-1000.step, L08R5000Q1.step, New Project.pdsprj, Placa_esp32.pdsprj]
2022-10-22 Se agregan librerias que se necesitan en el proyecto
2022-11-22 Se agrega comentarios de serial y eeprom
2023-01-13 Se modifican todos los archivos para añadir: 1-diferente numero de muestras para cada medicion. 2- Unidades de hasta tres digitos 3- Tipo de escala lineal o cuadratica para cada medicion 4- Espacio n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
    [Arduino to HD44780.fzz, I2C_menu.fzz, buttons_menu.fzz, focus_menu.fzz, functions_menu.fzz, getters_menu.fzz, glyph_menu.fzz, hello_menu.fzz]
2023-01-13 Se reparan bugs de medicion, ahora correcta, especialmente en la parte del promediado
    [eeprom.cpp, promediador.cpp, serial.cpp]
2023-01-13 Se termina menu de configuracion serial completo y se arreglan bugs de visualizacion
    [definesConfiguraciones.h, eeprom.cpp, eeprom.h, menu.cpp, serial.cpp, variablesGlobales.h]
2023-04-05 Versiones de prueba 1.2 falta subir la 1.4 que seria la final
